Jokersherlock/Frodo_low_runahead/doc/tb_note.md

# 2025.9.11

输出寄存器使得upc的跳转延迟槽增加为2，符合预期

stall信号会让upc停止+3的位置，如在upc=2时给出stall，upc会停在5处
