Jokersherlock/Frodo_low_runahead/article.md

# 一些问题

1.  折叠hash能不能写，怎么写？
2.  以Frodo为主还是以微指令为主?
   + FrodoKEM的A的数据规模使得Hash操作与矩阵乘法的并行在低资源开销场景成为必要的操作，但是因此带来较为复杂的控制流，因此我们提出……
   + 后量子密码的专业指令往往功能复杂，每一条指令需要单独辅以较为复杂的状态机，为此我们提出了基于微指令的控制方案，并选择了Frodo加以实践
3.  设计的每一条指令需不需要都写出来格式、功能是什么样的？微指令需不需要把每一位都写出来？
4. 体现控制开销小可以使用控制模块占总体开销的百分比（其他文章的能找到么？），但如何量化额外的rom带来的存储开销（现在的往大了预估不超过448B）

# Contribution

1. 提出了一种基于微指令的控制架构
2. 设计了一个适应低资源开销场景下的FrodoKEM的硬件实现方案
3. 折叠hash?
4. 低资源开销场景下,FrodoKEM的存储策略和计算数据流(和第二点应该是1个?)
