Jokersherlock/Frodo_low_runahead/doc/Frodo矩阵乘法结构优势附加说明文档.docx

# 本专利所使用的矩阵乘法单元结构与直接相连、TPU矩阵乘法结构对比

一、直接相连矩阵乘法结构

图1 直接相连矩阵乘法结构示意图

1、 计算方法：该结构一周期能够完成（4×4）×（4×1）的矩阵乘法，见式（1.1），通过扩展，可以在多周期内完成（4×4n）×（4n×1）的矩阵乘法，见式（1.2）。图1中展示的是直接相连矩阵乘法结构进行矩阵乘法运算示意图。在进行（4×4）×（4×1）的矩阵乘法时，每个周期读入4行（即16个）A矩阵系数，并将其对应输入到矩阵乘法运算单元（MUL）中；同时读入1列（即4个）s矩阵系数，并将其对应输入到MUL的每一列中。MUL模块中输入的A矩阵和s矩阵系数对应相乘，并将相乘后的每行元素进行相加，获得该周期运算结果。在扩展为（4×4n）×（4n×1）的矩阵乘法时，每个周期运算结果与上一周期结果进行累加，并在结果寄存器中缓存，直至完成输出矩阵元素所需的全部乘加操作。

[A_00 A_10 , A_01 A_11 , A_02 A_12 , A_03 A_13 A_20 A_30 , A_21 A_31 , A_22 A_32 , A_23 A_33 ]×[s_00 s_10 s_20 s_30 ]=[B_00 B_10 B_20 B_30 ] … (1.1)

[A_00 A_10 , A_01 A_11 , A_02 A_12 , A_03 A_13 A_20 A_30 , A_21 A_31 , A_22 A_32 , A_23 A_33 A_04 A_14 , A_05 A_15 , A_06 A_16 , A_07 A_17 A_24 A_34 , A_25 A_35 , A_26 A_36 , A_27 A_37 ]×[s_00 s_10 s_20 s_30 s_40 s_50 s_60 s_70 ]=[B_00 B_10 B_20 B_30 ] … (1.2)

周期 | CC0 | CC1 | ….
矩阵A输入 | A_00 , A_01 , A_02 , A_03 A_10 , A_11 , A_12 , A_13 A_20 , A_21 , A_22 , A_23 A_30 , A_31 , A_32 , A_33 | A_04 , A_05 , A_06 , A_07 A_14 , A_15 , A_16 , A_17 A_24 , A_25 , A_26 , A_27 A_34 , A_35 , A_36 , A_37 | ….
矩阵s输入 | s_00 , s_10 , s_20 , s_30 | s_40 , s_50 , s_60 , s_70 | ….

CC0：输入 A 矩阵和 s 矩阵的前四行系数。执行 s_00 与矩阵 A 第一列各元素的乘法操作， s_10 与矩阵 A 第二列各元素的乘法操作， s_20 与矩阵 A 第三列各元素的乘法操作， s_30 与矩阵 A 第四列各元素的乘法操作。将已计算获得的 s 矩阵系数与 A 矩阵的第一行前四列系数对应相乘的结果相加，即执行 A_00 s_00 +A_01 s_10 +A_02 s_20 +A_03 s_30 操作，获得 B_00 中间过程值，并将其缓存在计算单元中。 B_10 ， B_20 ， B_30 中间过程值的计算与缓存过程以此类推。

CC1：输入 A 矩阵和 s 矩阵的后四行系数。执行 s 00与矩阵 A 第五列各元素的乘法操作， s 10与矩阵 A 第六列各元素的乘法操作， s 20与矩阵 A 第七列各元素的乘法操作， s 30与矩阵 A 第八列各元素的乘法操作。将已计算获得的 s 矩阵系数与 A 矩阵的第一行系数后四列对应相乘的结果相加，即执行 A_04 s_40 +A_05 s_50 +A_06 s_60 +A_07 s_70 操作，再与缓存的中间过程值累加，获得 B_00 最终计算结果。 B_10 ， B_20 ， B_30 的计算过程以此类推。

CC2~CCn：依次类推，直至完成全部矩阵乘法运算。

2、所需最大带宽： （4 data+16 data）×16bit/data=320 bit。

3、计算 (m×n)×(n×k) 矩阵所需周期： m/4×n/4×k=(m×n×k)/16 。以（640×640）×（640×8）为例，所需周期为204800。

4、所需乘法器、加法器与寄存器个数： 16个乘法器，16个加法器，20个16-bit寄存器（4个16-bit寄存器用于存储计算结果， 16个16-bit寄存器用于储存当前乘法结果）。

2、 TPU矩阵乘法结构

图2 TPU矩阵相乘结构

1、计算方法：该结构可以在多周期内完成（4×4n）×（4n×4）的矩阵乘法，以（4×8）×（8×4）为例，见式（1.3）。以矩阵A与矩阵s相乘的过程（矩阵维度均为4×4）为例，见式（1.2）。将A矩阵与s矩阵系数以一种类似平行四边形的顺序输入到矩阵运算单元的硬件电路中，并在硬件电路内部进行数据流动，实现数据的时分复用。计算细节如下所示：

[A_00 A_10 , A_01 A_11 , A_02 A_12 , A_03 , A_04 , A_05 , A_06 , A_07 A_13 , A_14 , A_15 , A_16 , A_17 A_20 A_30 , A_21 A_31 , A_22 A_32 , A_23 , A_24 , A_25 , A_26 , A_27 A_33 , A_34 , A_35 , A_36 , A_37 ]×[s_00 s_10 , s_01 s_11 , s_02 s_12 , s_03 s_13 s_20 s_30 s_40 s_50 s_60 s_70 , s_21 s_31 s_41 s_51 s_61 s_71 , s_22 s_32 s_42 s_52 s_62 s_72 , s_23 s_33 s_43 s_53 s_63 s_73 ]=[B_00 B_10 , B_01 B_11 , B_02 B_12 , B_03 B_13 B_20 B_30 , B_21 B_31 , B_22 B_32 , B_23 B_33 ]

… (1.3)

计算细节：

周期 | CC0 | CC1 | CC2 | CC3 | CC4 | ….
矩阵A 输入 | A30 | A31, A20 | A32, A21, A10 | A33, A22, A11, A00 | A34, A23, A12, A01 | ….
矩阵s 输入 | s00 | s10, s01 | s20, s11, s02 | s30, s21, s12, s03 | s40, s31, s22, s13 | ….

CC0：在乘法单元第1列，第四行位的MAC单元中执行A30×s00的乘法操作，并将结果缓存在计算单元中。

CC1：在矩阵第1列，第3~4行的MAC单元中，分别执行A20×s00，A31×s10的操作，并将结果与缓存结果相加；在矩阵第2列，第4行的MAC单元中，执行A30×s01的操作，并将结果缓存在计算单元中。

CC2：在矩阵第1列，第2~4行的MAC单元中，分别执行A10×s00，A21×s10，A32×s20的操作，并将结果与缓存结果相加；同时在矩阵第2列，第3~4行的MAC单元中，分别执行A20×s01，A31×s11的操作，并将结果与缓存结果相加；同时在矩阵第3列，第4行的MAC单元中，执行A30×s02的操作，并将结果缓存在计算单元中。

CC3：在矩阵第1列，第1~4行的MAC单元中，分别执行A30×s00，A30×s00，A30×s00，A30×s00的操作，并将结果与缓存结果相加，此时，完成B30元素的全部计算；在矩阵第2列，第2~4行的MAC单元中，分别执行A10×s01，A21×s11，A32×s21的操作，并将结果与缓存结果相加；同时在矩阵第3列，第3~4行的MAC单元中，分别执行A20×s02，A31×s12的操作，并将结果与缓存结果相加；同时在矩阵第4列，第4行的MAC单元中，执行A30×s03的操作，并将结果缓存在计算单元中。

CC4：在矩阵第1列，第1~4行的MAC单元中，分别执行A30×s00，A30×s00，A30×s00，A30×s00的操作，并将结果与缓存结果相加，此时，完成B30元素的全部计算；在矩阵第2列，第1~4行的MAC单元中，分别执行A10×s01，A21×s11，A32×s21的操作，并将结果与缓存结果相加；同时在矩阵第3列，第2~4行的MAC单元中，分别执行A20×s02，A31×s12的操作，并将结果与缓存结果相加；同时在矩阵第4列，第4行的MAC单元中，第3~4行的MAC单元中，分别执行A20×s02，A31×s12的操作，并将结果与缓存结果相加。

CC5~CCn：依次类推，直至完成全部矩阵乘法运算。

2、为保证乘法阵列电路流水运行所需带宽： （4 data+4 data）×16 bit/data=128 bit 。

3、计算 (m×n)×(n×k) 矩阵所需周期： 10+4×（m/4×n/4×k/4−1） 。以（640×640）×（640×8）为例，所需周期为204806。

4、所需乘法器、加法器与寄存器个数：16个乘法器，16个加法器，40个16-bit寄存器（16个16-bit寄存器用于存储累加结果，12个16-bit寄存器用于存储A矩阵元素，12个16-bit寄存器用于存储s矩阵元素）。

三、本专利所使用的矩阵相乘结构

图4 一种适用于Frodo算法的矩阵乘法结构

1、 计算方法：该结构可以在多周期内完成（4×4n）×（4n×4）的矩阵乘法，以（4×8）×（8×4）为例，见式（1.4）。矩阵A内部各元素按反斜向对角顺序依次输入硬件计算电路，每个元素同时连接到4个计算单元的输入端口，实现空间上的数据复用。矩阵s内部各元素按行输入硬件计算电路，并在硬件电路内部进行流动，实现时间上的数据复用。每周期乘法运算结果在乘法单元内部缓存，并与下一周期计算结果进行累加，直至完成输出矩阵元素所需的全部乘加操作。

[A_00 A_10 , A_01 A_11 , A_02 A_12 , A_03 , A_04 , A_05 , A_06 , A_07 A_13 , A_14 , A_15 , A_16 , A_17 A_20 A_30 , A_21 A_31 , A_22 A_32 , A_23 , A_24 , A_25 , A_26 , A_27 A_33 , A_34 , A_35 , A_36 , A_37 ]×[s_00 s_10 , s_01 s_11 , s_02 s_12 , s_03 s_13 s_20 s_30 s_40 s_50 s_60 s_70 , s_21 s_31 s_41 s_51 s_61 s_71 , s_22 s_32 s_42 s_52 s_62 s_72 , s_23 s_33 s_43 s_53 s_63 s_73 ]=[B_00 B_10 , B_01 B_11 , B_02 B_12 , B_03 B_13 B_20 B_30 , B_21 B_31 , B_22 B_32 , B_23 B_33 ]

… (1.4)

周期 | CC0 | CC1 | CC2 | CC3 | CC4 | ….
矩阵A输入 | A00 | A01，A10 | A02，A11，A20 | A03，A12，A21，A30 | A04，A13，A22，A31 | ….
矩阵s 输入 | s00, s01, s02, s03 | s10, s11, s12, s13 | s20, s21, s22, s23 | s30, s31, s32, s33 | s40, s41, s42, s43 | ….

CC0：执行A00与矩阵s第一行各元素的乘法操作，并将结果缓存在计算单元中。

CC1：执行A01与矩阵s第二行各元素的乘法操作，并将结果与缓存结果相加；同时执行A10与矩阵s第一行各元素的乘法操作，并将结果缓存在计算单元中。

CC2：执行A02与矩阵s第三行各元素的乘法操作，并将结果与缓存结果相加；同时执行A11与矩阵s第二行各元素的乘法操作，并将结果与缓存结果相加；同时执行A20与矩阵s第一行各元素的乘法操作，并将结果缓存在计算单元中。

CC3：执行A03与矩阵s第四行各元素的乘法操作，并将结果与缓存结果相加；同时执行A12与矩阵s第三行各元素的乘法操作，并将结果与缓存结果相加；同时执行A21与矩阵s第二行各元素的乘法操作，并将结果与缓存结果相加。同时执行A30与矩阵s第一行各元素的乘法操作，并将结果缓存在计算单元中。

CC4：执行A04与矩阵s第五行各元素的乘法操作，并将结果与缓存结果相加；同时执行A13与矩阵s第四行各元素的乘法操作，并将结果与缓存结果相加；同时执行A22与矩阵s第三行各元素的乘法操作，并将结果与缓存结果相加。同时执行A31与矩阵s第二行各元素的乘法操作，并将结果缓存在计算单元中。

CC5~CCn：依次类推，直至完成全部矩阵乘法运算。

2、所需最大带宽： （4 data+4 data）×16 bit/data=128 bit。

3、计算 (m×n)×(n×k) 矩阵所需周期： 4×m/4×n/4×k/4+3 。以（640×640）×（640×8）为例，所需周期为204803。

4、所需乘法器、加法器与寄存器个数：16个乘法器，16个加法器，28个16-bit寄存器（16个16-bit寄存器用于存储累加结果， 12个16-bit寄存器用于存储s矩阵元素）。

以硬件乘法单元进行（640×640）×（640×8）计算为例：

| 所需带宽（bit） | 所需周期数 | 资源开销 | | | 乘法阵列维度
| | | 乘法器 | 加法器 | 寄存器
直接相连结构 | 320 | 204800 | 16 | 16 | 20 | （4×4）×（4×1）
TPU结构 | 128 | 204806 | 16 | 16 | 40 | （4×4）×（4×4）
本专利 结构 | 128 | 204803 | 16 | 16 | 28 | （4×4）×（4×4）

与直接相连结构相比，在所需周期数几乎相同的情况下，本专利结构所需的带宽仅为直接相连结构的2/5，这一优化显著减轻了数据传输过程中对于带宽的压力,同时直接相连结构只能单次计算（4×4n）×（4n×1）矩阵相乘，而本设计结构能单次计算（4×4n）×（4n×4）矩阵相乘。与TPU结构相比，在所需带宽相同，所需周期数几乎相同的情况下，所需寄存器的个数明显少于TPU结构，有着更出色的资源利用效率。

综上所述，本专利结构在显著降低带宽需求的同时，减少了寄存器资源消耗，为提高Frodo算法中矩阵乘法硬件执行速度提供一种高性能、高资源利用率的硬件实现方案。
