Jokersherlock/Frodo_low_runahead/doc/Frodo硬件实现评估报告-低资源开销-第二部分.docx

全安全等级Frodo硬件实现评估报告

低资源开销设计（第二部分）

版本：Ver. 1.4

审核人：陆家昊

批准人：刘冬生

编写人：赵正鹏、王家琛

##### 版本记录

序号 | 版本号 | 生成时间 | 主 要 修 改 记 录 | 作者
| V1.0 | 20250713 | 创建文档 | 赵正鹏、王家琛
| V1.1 | 20250720 | 完成第一版报告 | 赵正鹏、王家琛
| V1.2 | 20250725 | 增添PTPX分析与实际上板波形 | 赵正鹏、王家琛

# 目录

# 1. 仿真结果

## 1.1. 仿真结果验证

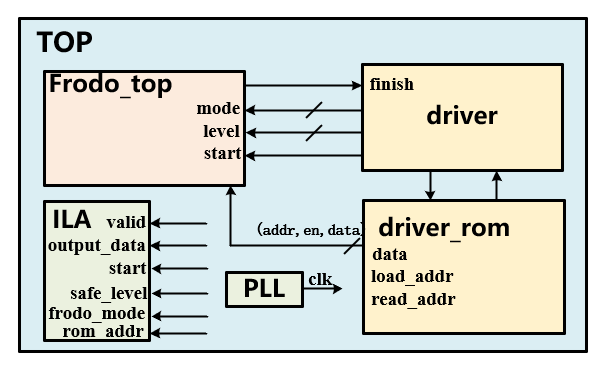
[picture p2: figure]

上图为测试仿真方案，Frodo本体（Frodo_top）与驱动（driver）被封装在一个TOP中，diver控制driver_rom对Frodo内RAM进行数据的初始化，完成初始化后向本体发送安全等级（level）、具体算法（mode）、工作启动信号（start），开始执行Frodo算法，在一个算法流程执行完毕后，diver控制driver_rom从RAM中读出运算结果数据。

输出数据的地址规划（用于结果的正确性验证）：

pkh(Keygen) | RAM1 | 0xFD2~0xFD5
ss(Encap) | RAM0 | 0xFFC~0xFFF
ss(Decap) | RAM1 | 0xFD6~0xFD9

仿真测试初始数据：

FrodoKEM 640 SHAKE | s_seedSE_z randomness: 7c9935a0b07694aa0c6d10e4db6b1add2fd81a25ccb148032dcd739936737f2db505d7cfad1b497499323c8686325e4792f267aafa3f87ca60d01cb54f29202a mu_salt randomness: eb4a7c66ef4eba2ddb38c88d8bc706b1d639002198172a7b1942eca8f6c001ba26202bee59ac275484ea767d41d8d357
FrodoKEM 976 SHAKE | s_seedSE_z randomness: 7c9935a0b07694aa0c6d10e4db6b1add2fd81a25ccb148032dcd739936737f2db505d7cfad1b497499323c8686325e4792f267aafa3f87ca60d01cb54f29202a3e784ccb7ebcdcfd45542b7f6af778742e0f4479175084aa mu_salt randomness: ee716762c15e3b72aa7650a63b9a510040b03c0fe70475c0463bbc45a0ba5b7980dd46eef82fb062035077d042f306bb6391040e0dd965f1fda9d183ca9fccb48fc010b184ab0033
FrodoKEM 1344 SHAKE | s_seedSE_z randomness: 7c9935a0b07694aa0c6d10e4db6b1add2fd81a25ccb148032dcd739936737f2db505d7cfad1b497499323c8686325e4792f267aafa3f87ca60d01cb54f29202a3e784ccb7ebcdcfd45542b7f6af778742e0f4479175084aa488b3b74340678aa38e22e9628b0a161fdeb0bd252173b9c mu_salt randomness: 9f08587687ff66765c671de73e918d2823ca573ff4e7a31a9160324026e540eacb3a04e0d54c75deb9705bfdfbdf935a7528802ee6e5b0c6a73b2b761d9bd0848a6e4cf3fc4ca84f14e0331af35bfef41e42b13a6dae6df937f738c1857ba1ca

### 1.1.1. Frodo640

硬件仿真结果

Keygen生成pkh

mem1_addr = fd2 , output_data = db2e85b3977dca13

mem1_addr = fd3 , output_data = adfb88507c1be248

软件结果(左为低位)：

//pkh

13ca7d97b3852edb

48e21b7c5088fbad

Encaps生成ss

mem0_addr = ffc , output_data = 11fbdbd5e72cd42e

mem0_addr = ffd , output_data = fab350b6dc2b2e5f

软件结果(左为低位)：

//ss(Encaps)

2ed42ce7d5dbfb11

5f2e2bdcb650b3fa

Decaps生成ss

mem1_addr = fd6 , output_data = 11fbdbd5e72cd42e

mem1_addr = fd7 , output_data = fab350b6dc2b2e5f

软件结果(左为低位)：

//ss(Decaps)

2ed42ce7d5dbfb11

5f2e2bdcb650b3fa

通过比对，数据一致，说明Frodo640安全等级下，各算法流程执行正确

### 1.1.2. Frodo976

硬件仿真结果

Keygen生成pkh

mem1_addr = fd2 , output_data = 3e04668a8d7a1f9b

mem1_addr = fd3 , output_data = af5072a3962884da
mem1_addr = fd4 , output_data = cfc763dd12a3802c

软件结果(左为低位)：

//pkh

9b1f7a8d8a66043e

da842896a37250af

2c80a312dd63c7cf

Encaps生成ss

mem0_addr = ffc , output_data = e7f8d5a3695a6e5b

mem0_addr = ffd , output_data = d05e59956e3aea5e
mem0_addr = ffd , output_data = 4231378b5ba58d27

软件结果(左为低位)：

//ss(Encaps)

5b6e5a69a3d5f8e7

5eea3a6e95595ed0

278da55b8b373142

Decaps生成ss

mem1_addr = fd6 , output_data = e7f8d5a3695a6e5b

mem1_addr = fd7 , output_data = d05e59956e3aea5e
mem1_addr = fd8 , output_data = 4231378b5ba58d27

软件结果(左为低位)：

//ss(Dncaps)

5b6e5a69a3d5f8e7

5eea3a6e95595ed0

278da55b8b373142

通过比对，数据一致，说明Frodo976安全等级下，各算法流程执行正确

### 1.1.3. Frodo1344

硬件仿真结果

Keygen生成pkh

mem1_addr = fd2 , output_data = 1620695d8773363a

mem1_addr = fd3 , output_data = 96ba22f90b7b5e27
mem1_addr = fd4 , output_data = df0445d51223a7b1

mem1_addr = fd5 , output_data = 797d67e53576d438

软件结果(左为低位)：

//pkh

3a3673875d692016

275e7b0bf922ba96

b1a72312d54504df

38d47635e5677d79

Encaps生成ss

mem0_addr = ffc , output_data = 9ef14d4671f9208d

mem0_addr = ffd , output_data = e2d0af85d3bd6105

mem0_addr = ffd , output_data = 635ad4ef12e20cef

mem0_addr = ffe , output_data = ac6ad6f3642c5d2f

软件结果(左为低位)：

//ss(Encaps)

8d20f971464df19e

0561bdd385afd0e2

ef0ce212efd45a63

2f5d2c64f3d66aac

Decaps生成ss

mem1_addr = fd6 , output_data = 9ef14d4671f9208d

mem1_addr = fd7 , output_data = e2d0af85d3bd6105
mem1_addr = fd8 , output_data = 635ad4ef12e20cef

mem1_addr = fd9 , output_data = ac6ad6f3642c5d2f

软件结果(左为低位)：

//ss(Decaps)

8d20f971464df19e

0561bdd385afd0e2

ef0ce212efd45a63

2f5d2c64f3d66aac

通过比对，数据一致，说明Frodo1344安全等级下，各算法流程执行正确

### 1.1.4. 运算时间评估

工程在switch信号上升沿来临开始进行某一算法流程测试，在初始化必要的输入数据后驱动会拉高start从而Frodo本体进行工作，运算结束后valid信号会拉高。一个算法流程的所耗时间从start信号的上升沿开始至valid信号上升沿结束。

以Frodo640为例，可见一个等级下的算法流程运行顺序

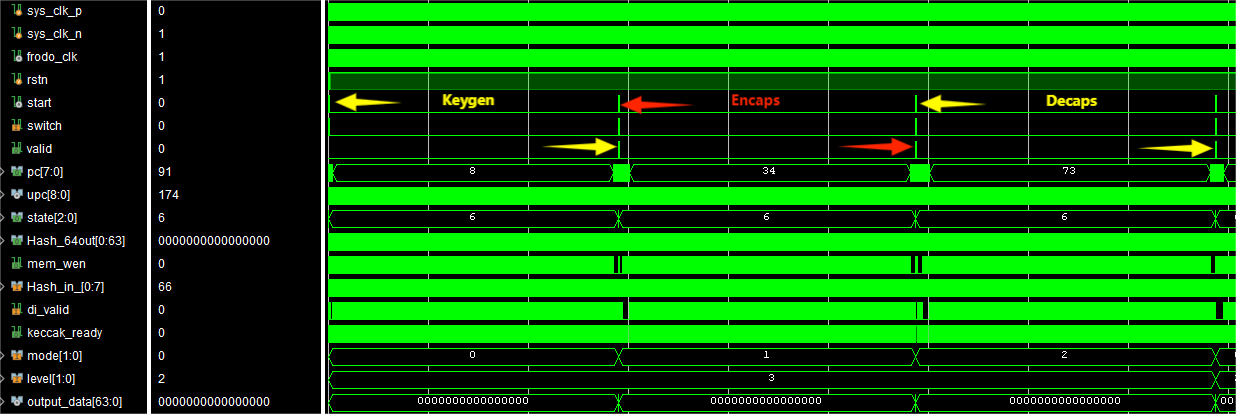
[picture p3: figure]

为方便计算，设置驱动时钟(Frodo_clk)为100Mhz

Frodo640-keygen：

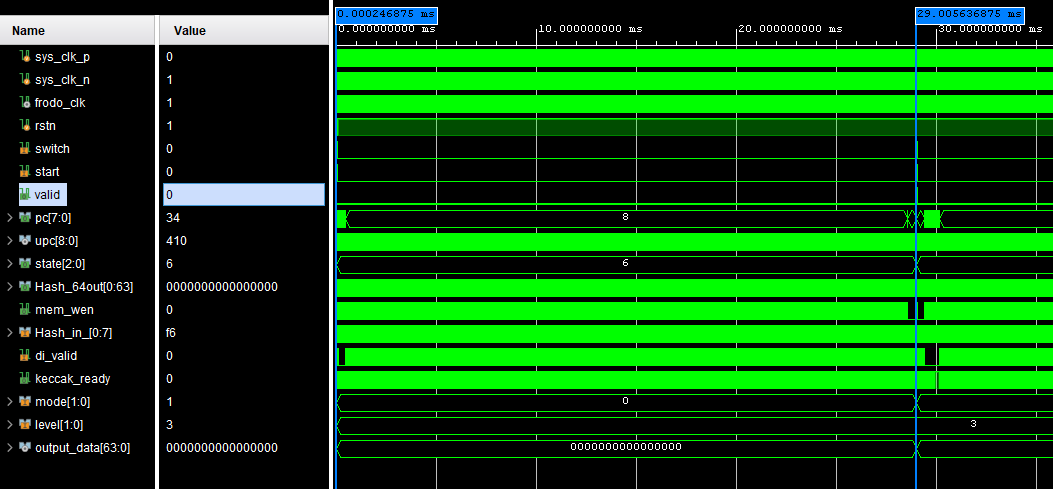
[picture p4: figure]

耗时29,005,390ns，共计2,900,539个周期

Frodo640-Encaps：

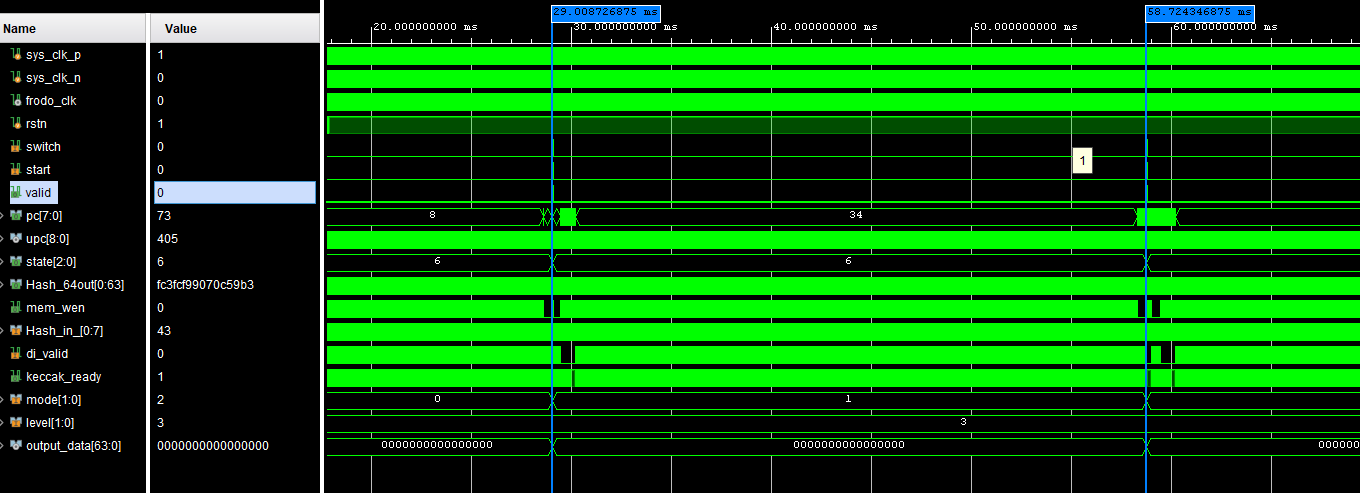
[picture p5: figure]

耗时29,715,620ns，共计2,971,562个周期

Frodo640-Decaps：

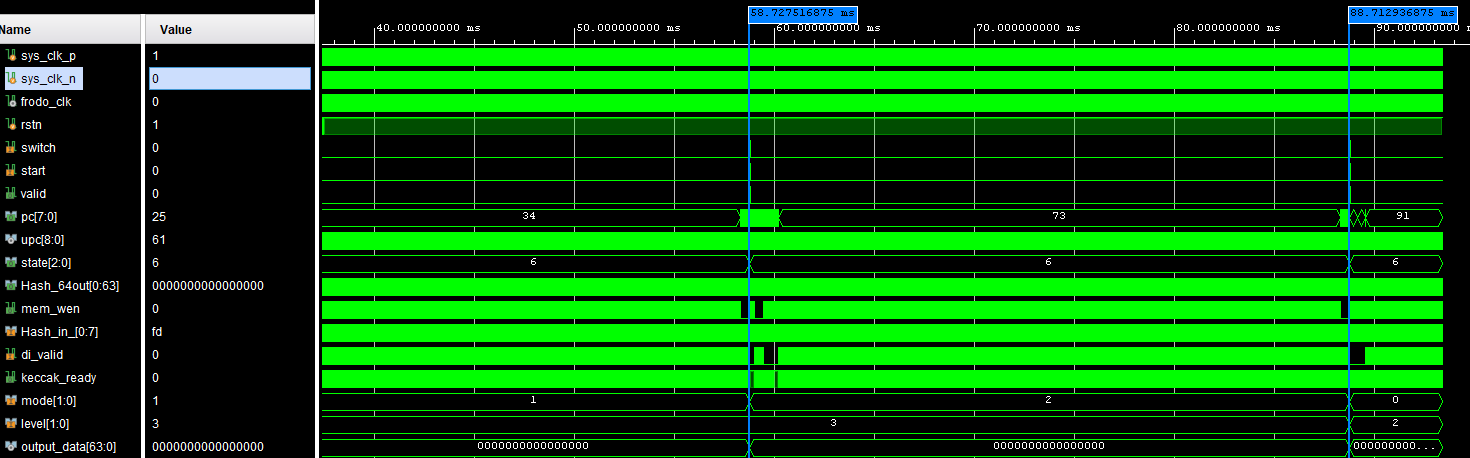
[picture p6: figure]

耗时29,985,420ns，共计2,998,542个周期

Frodo976-keygen：

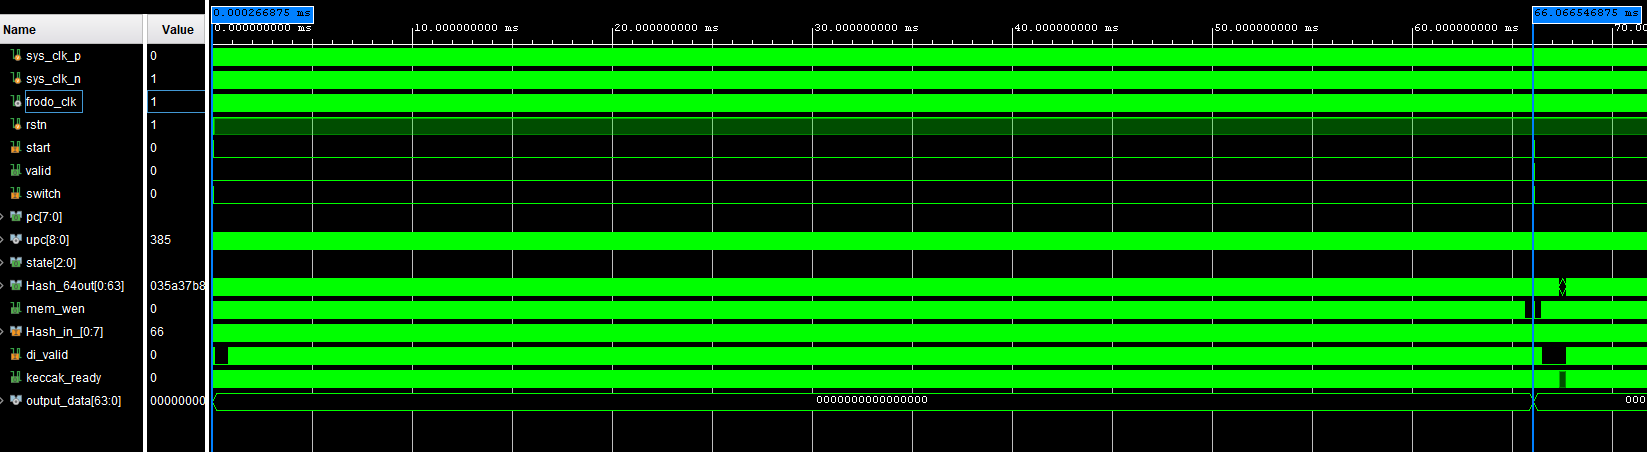
[picture p7: figure]

耗时66,063,280ns，共计6,606,328个周期

Frodo976-Encaps：

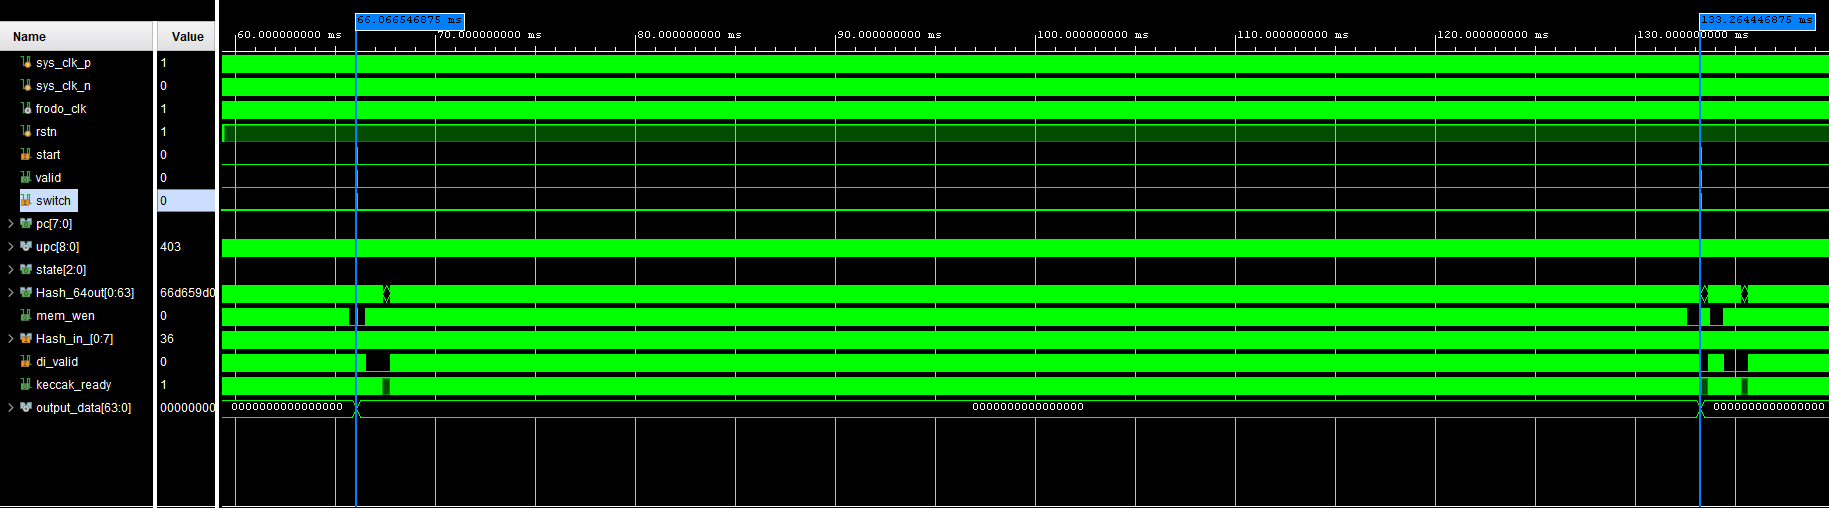
[picture p8: figure]

耗时67,194,600ns，共计6,719,460个周期

Frodo976-Decaps

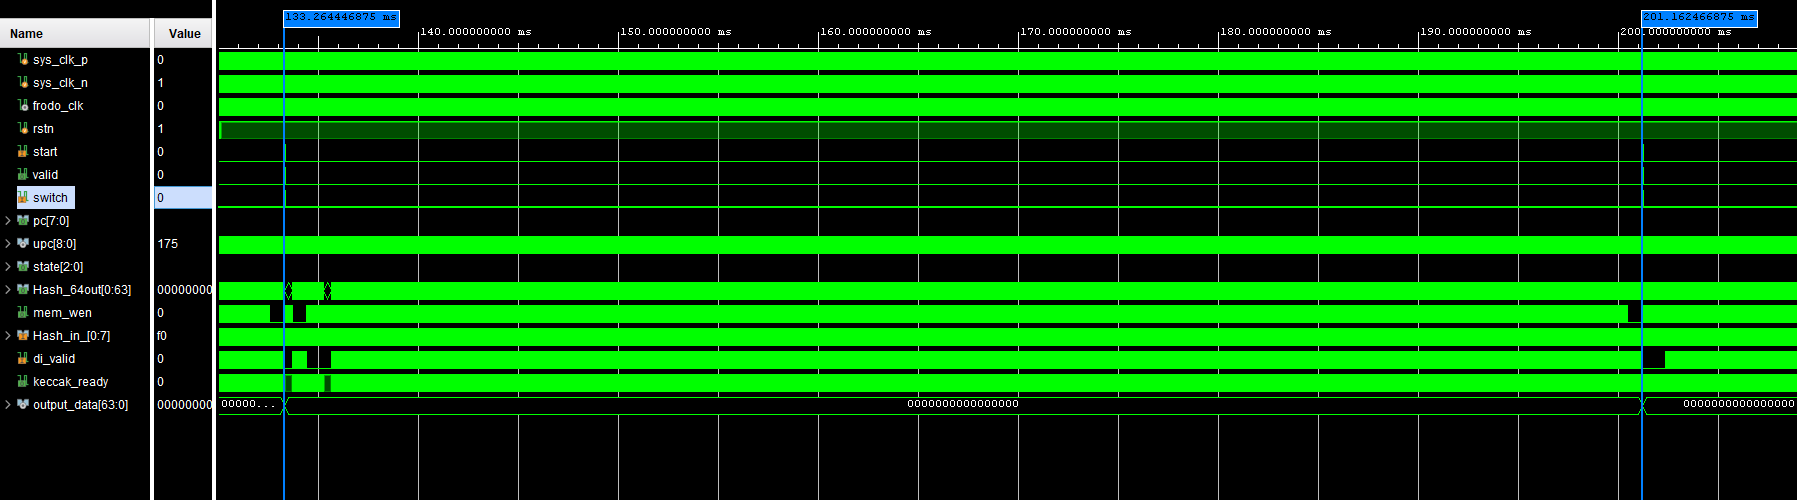
[picture p9: figure]

耗时67,898,030ns，共计6,789,803个周期

Frodo1344-keygen

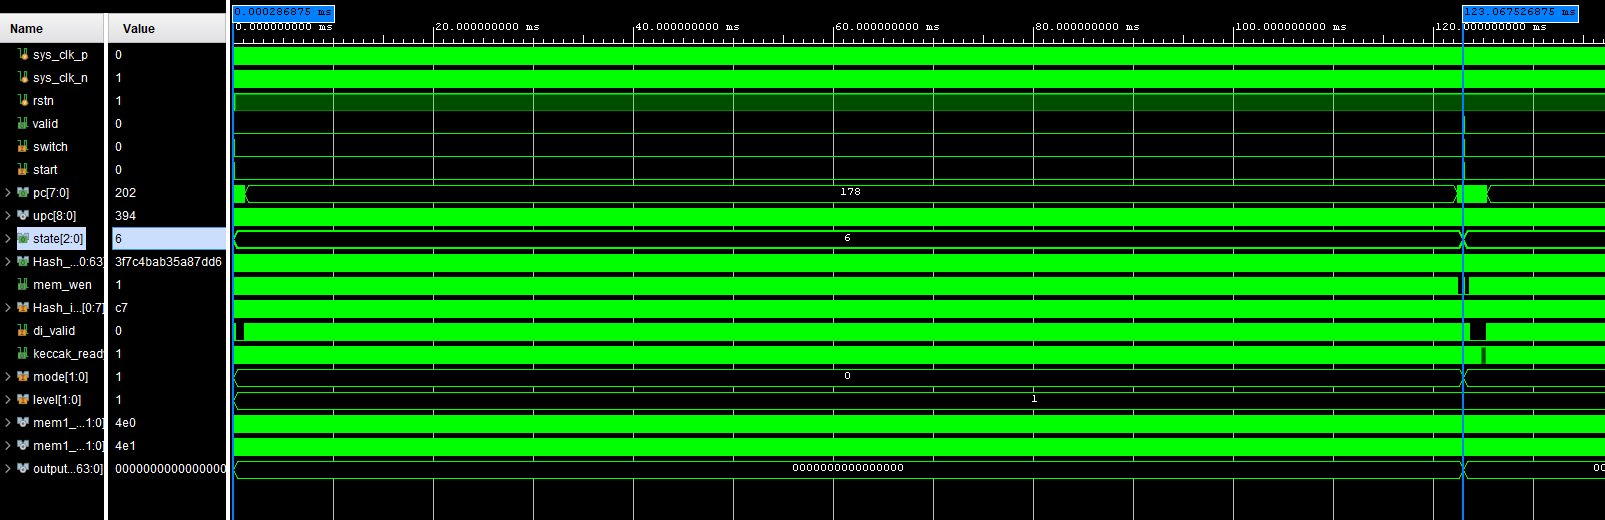
[picture p10: figure]

耗时123,067,240ns，共计12,306,724个周期

Frodo1344-Encaps

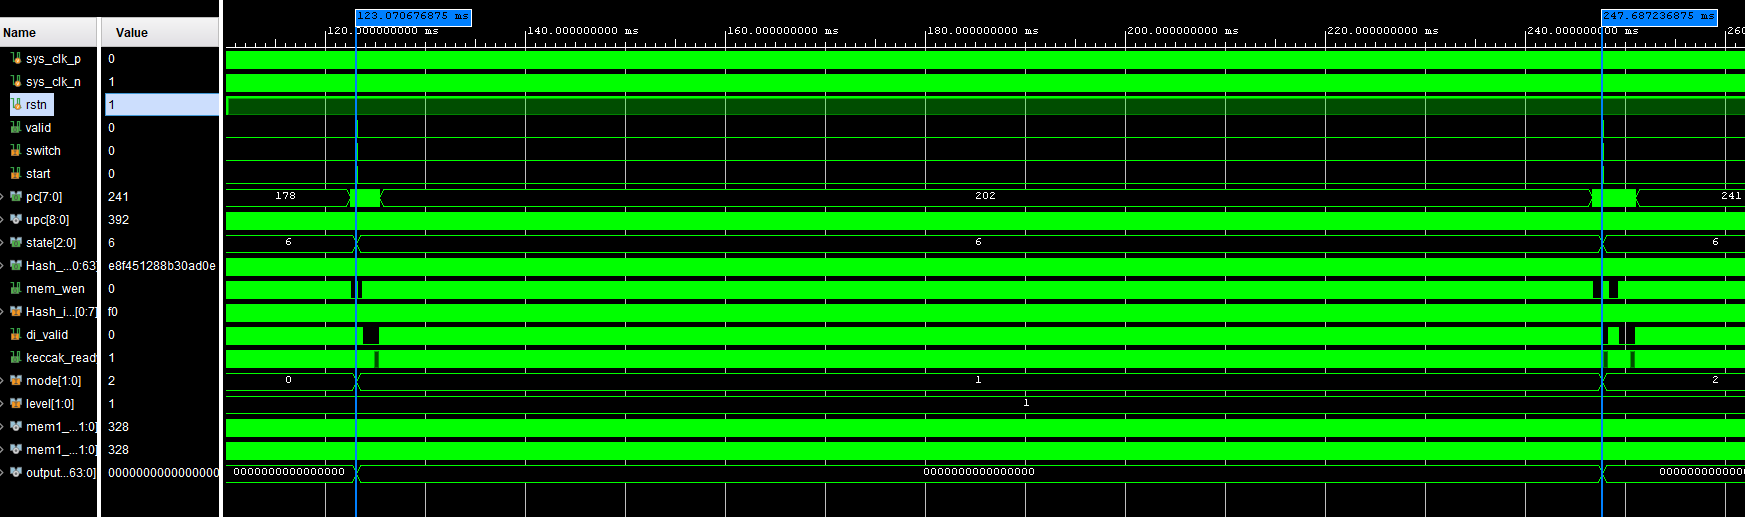
[picture p11: figure]

耗时124,616,560ns，共计12,461,656个周期

Frodo1344-Decaps

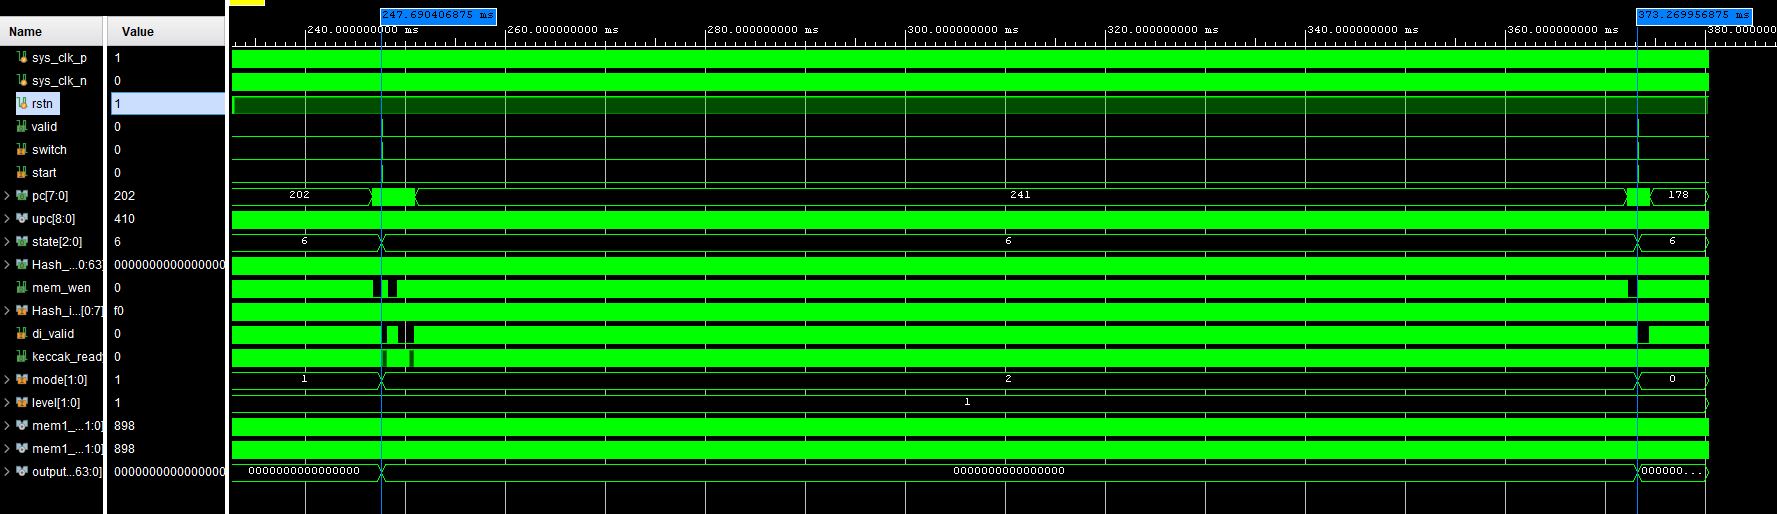
[picture p12: figure]

耗时125,579,550ns，共计12,557,955个周期

运行周期数 | Keygen | Encaps | Decaps
Frodo640 | 2,900,539 | 2,971,562 | 2,998,542
Frodo976 | 6,606,328 | 6,719,460 | 6,789,803
Frodo1344 | 12,306,724 | 12,461,656 | 12,557,955

运行时间(100MHz时钟下) | Keygen | Encaps | Decaps
Frodo640 | 29.01ms | 29.71ms | 29.99ms
Frodo976 | 66.06ms | 67.19ms | 67.90ms
Frodo1344 | 123.07ms | 124.61ms | 125.58ms

## 1.2. 子模块仿真波形

### 1.2.1. RAM读写

整体波形：

RAM的直接相连端口为mem_xx_xx信号，通过驱动传入的RAM端口信号为load_addr、load_data、load_en、read_addr、read_data，Frodo本体控制的RAM端口信号为Frodo_xx。在不同阶段mem_xx信号会与驱动传入信号或Frodo本体控制的RAM端口相连。

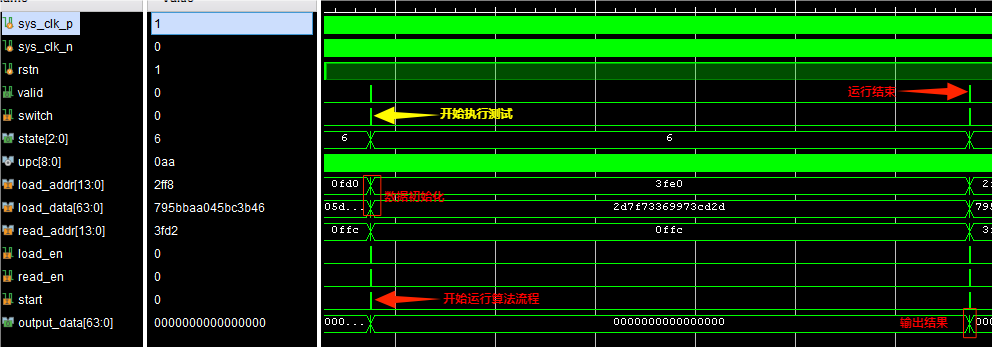
[picture p13: figure]

运行算法流程前的初始化数据：

此时RAM的地址与写数据端口分别受load_addr与load_data驱动，其中load_addr高两位为RAM索引区分此时控制RAM1还是RAM0.

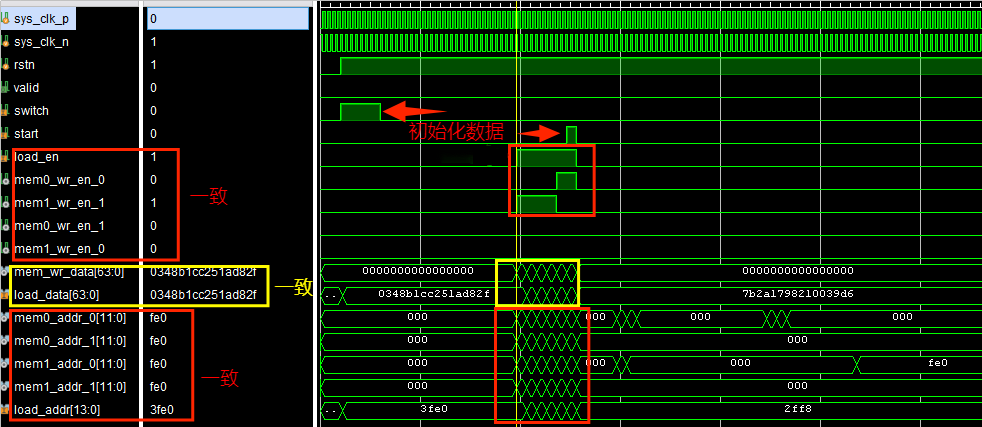
[picture p14: figure]

运行算法流程：

此时RAM的地址与写数据端口分别受frodo_memx_addr_x与frodo_mem_wr_data驱动。

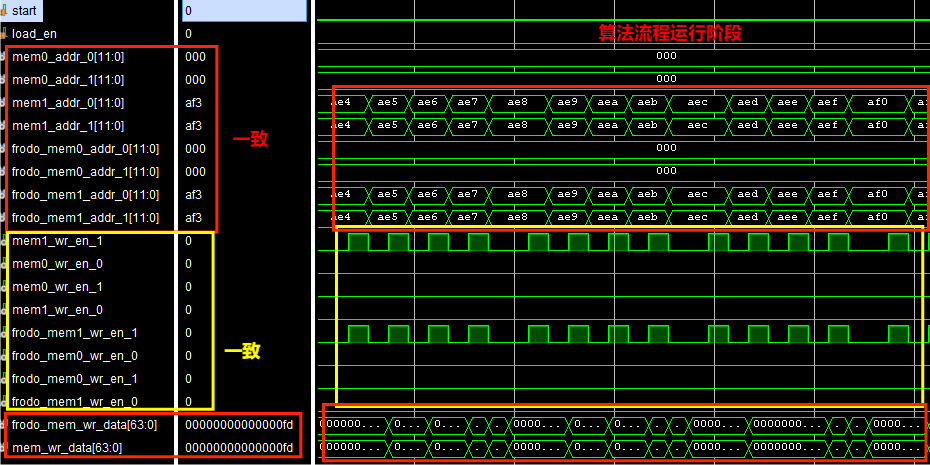
[picture p15: figure]

结束算法流程后读出结果数据：

此时RAM的地址受read_addr驱动,读数据会连至output_data。

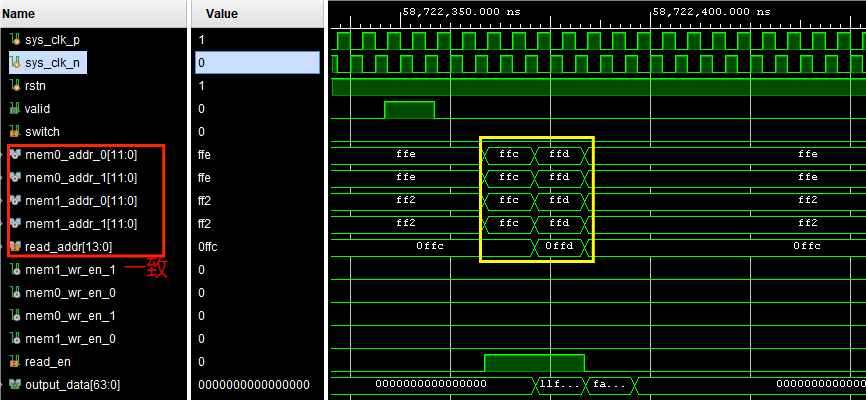
[picture p16: figure]

### 1.2.2. 指令执行

指令控制体系采取二级指令调度，一个指令指示一个工作(如:矩阵运算，输出S)的运行，指令给出所需参数。通过待机-取指-译码-执行的流程控制子模块，在执行阶段，通过一条条微指令进行具体子模块信号的控制。

单指令下波形：

多个指令整体波形：

一个指令对应一个待机-取指-译码-执行的流程循环。

### 1.2.3. 哈希模块

下图为Hash模块工作仿真波形：

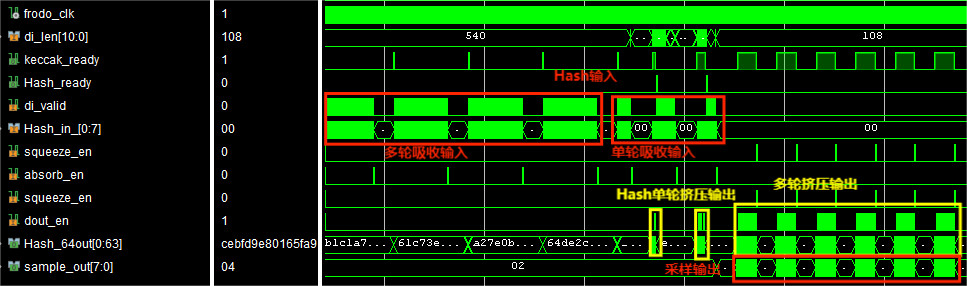
[picture p17: figure]

挤压输出的结果直接连到采样输出，根据具体情况决定是直接采用挤压输出值还是

采样输出值。

### 1.2.4. PE阵列

下图PE阵列工作过程仿真波形：

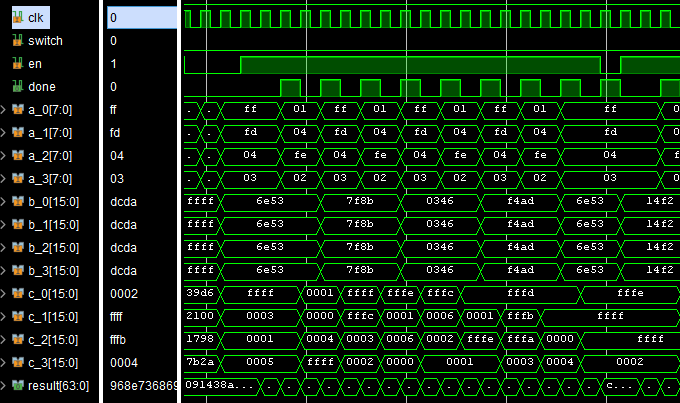
[picture p18: figure]

输入数据与使能有效后，下一个周期输出乘积，再下一周期输出乘加运算结果。输出数据位宽为64位，即将四个计算结果并行输出。

# 2. 硬件评估结果

Vivado版本:

Vivado v2024.2 (64-bit)

SW Build 5239630 on Fri Nov 08 22:35:27 MST 2024

IP Build 5239520 on Sun Nov 10 16:12:51 MST 2024

Tool Version Limit: 2024.11

Copyright 1986-2022 Xilinx, Inc. All Rights Reserved.

Copyright 2022-2024 Advanced Micro Devices, Inc. All Rights Reserved.

SharedData Build 5239561 on Fri Nov 08 14:39:27 MST 2024

FPGA型号:xcku15p-ffve1517-2-i

## 2.1. Synthesis结果

### 2.1.1. 硬件资源评估

综合后硬件资源评估结果如下，共消耗6359个LUT、4428个FF、19.5个BRAM和4个DSP。

其中Frodo本体(u_Frodo_top )共消耗5205个LUT、2730个FF、16个 BRAM和4个DSP。

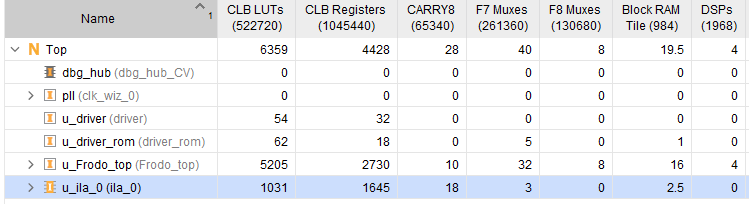
[picture p19: figure]

### 2.1.2. 最高频率估计

综合的时序评估如下，建立时间的裕度为4.841ns，评估得到的最高频193.8MHz。综合过程的Hold Slack不用考虑。

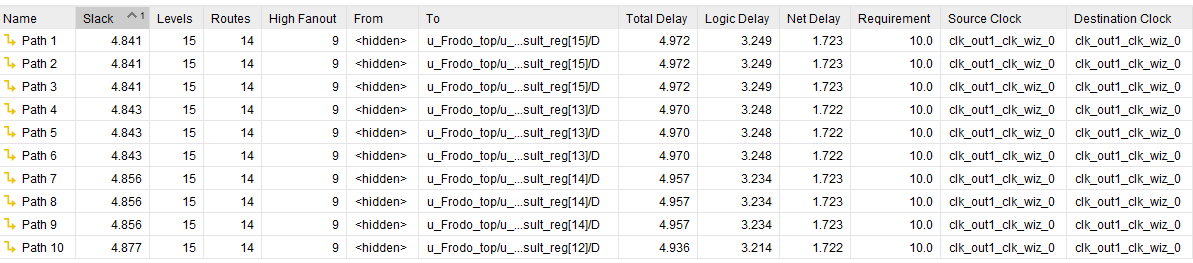
[picture p20: figure]

### 2.1.3. 功耗评估

### 功耗评估如下：

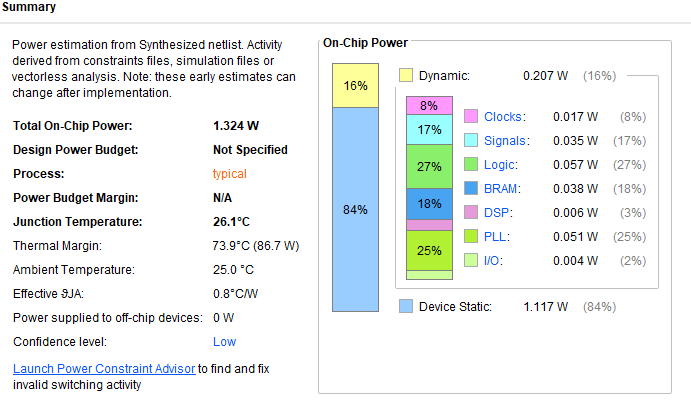
[picture p21: figure]

## 2.2. Implementation结果

### 2.2.1. 硬件资源评估

实现后硬件资源评估结果如下，共消耗6640个LUT、4923个FF、19.5个BRAM和4个DSP。

其中Frodo本体(u_Frodo_top )共消耗5144个LUT、2530个FF、16个 BRAM和4个DSP。

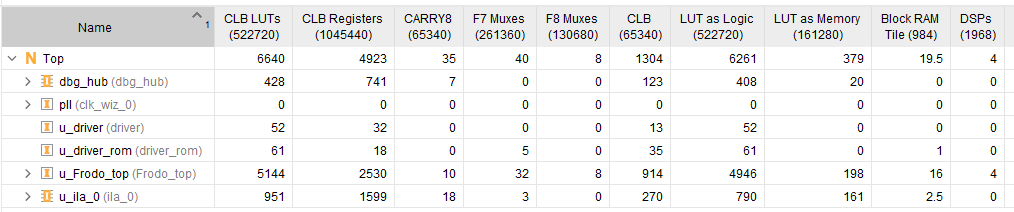
[picture p22: figure]

### 2.2.2. 最高频率估计

实现后的时序评估如下，建立时间的裕度为2.682ns，评估得到的最高频136.6MHz。

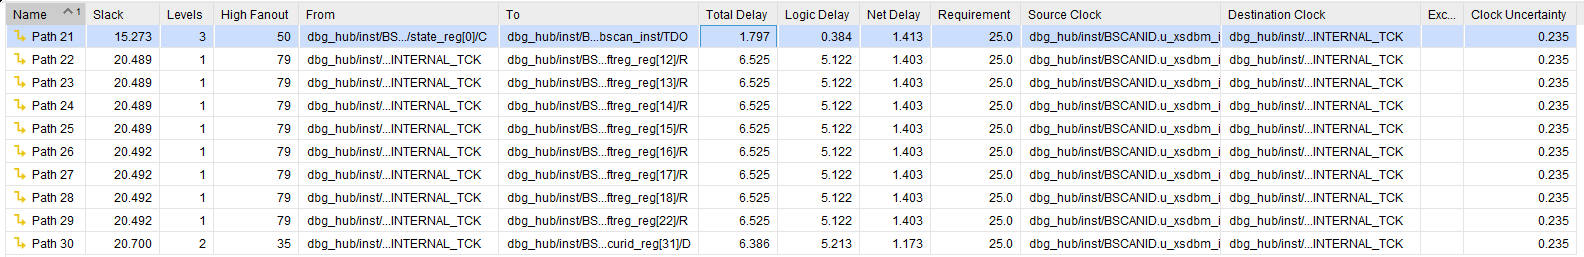
[picture p23: figure]
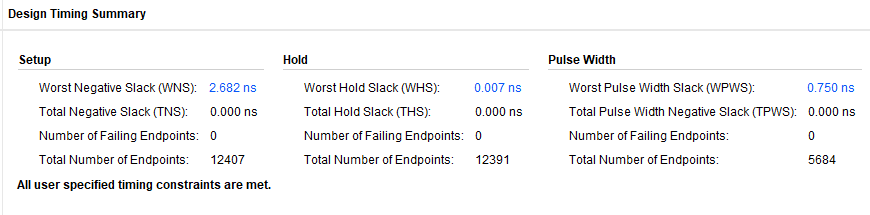
[picture p24: figure]

### 2.2.3. 功耗评估

### 功耗评估如下：

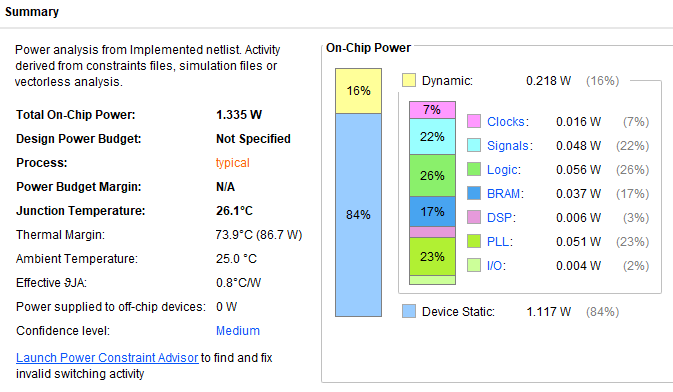
[picture p25: figure]

## 2.3. 等效逻辑门数评估

以下为DC综合所得Total cell area


可得Total cell area为166721.015792，保守估计等效逻辑门数为315,043.49，在31万等效逻辑门左右，远小于预期的100万门，且在不同驱动能力下等效逻辑门数可能有所降低，符合小于100万的门要求。

## 2.4. PTPX功耗分析

### 2.4.1. 在16Mhz时钟下功耗分析

16Mhz时钟下的PTPX功耗分析报告如下：

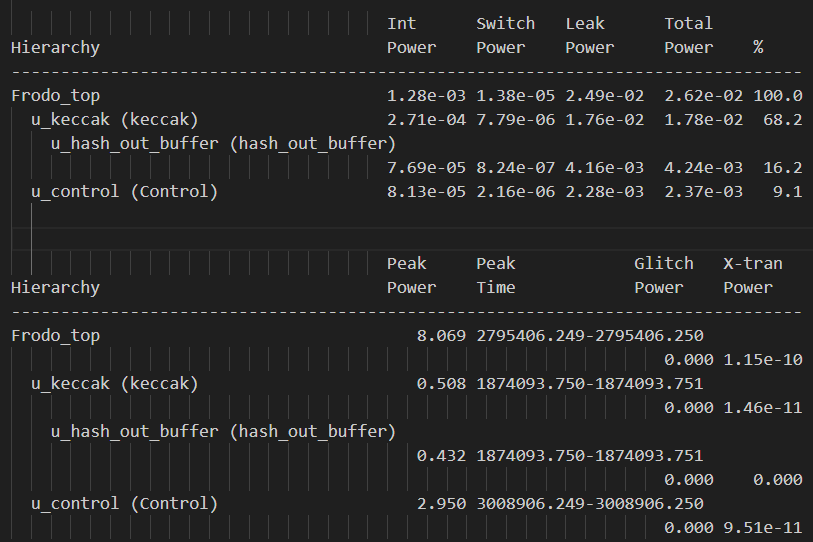
[picture p26: figure]

由图可知16Mhz下PTPX分析出的总峰值功耗为8.069w，其他数据如下表所示：

模块 | Int Power(w) | Swtich Power(w) | Leak Power(w) | Total Power(w)
总体工程 | 1.28e ⁻ ³ | 1.38e ⁻ ⁵ | 2.49e ⁻ ² | 2.62e ⁻ ²
keccak | 2.71e ⁻ ⁴ | 7.79e ⁻ ⁶ | 1.76e ⁻ ² | 1.78e ⁻ ²
Control | 8.13e ⁻ ⁵ | 2.16e ⁻ ⁶ | 2.28e ⁻ ³ | 2.37e ⁻ ³
其他模块 | 9.28e ⁻ ⁴ | 3.85e ⁻ ⁶ | 5.02e ⁻ ³ | 6.03e ⁻ ³

### 2.4.2. 在24Mhz时钟下功耗分析

16Mhz时钟下的PTPX功耗分析报告如下：

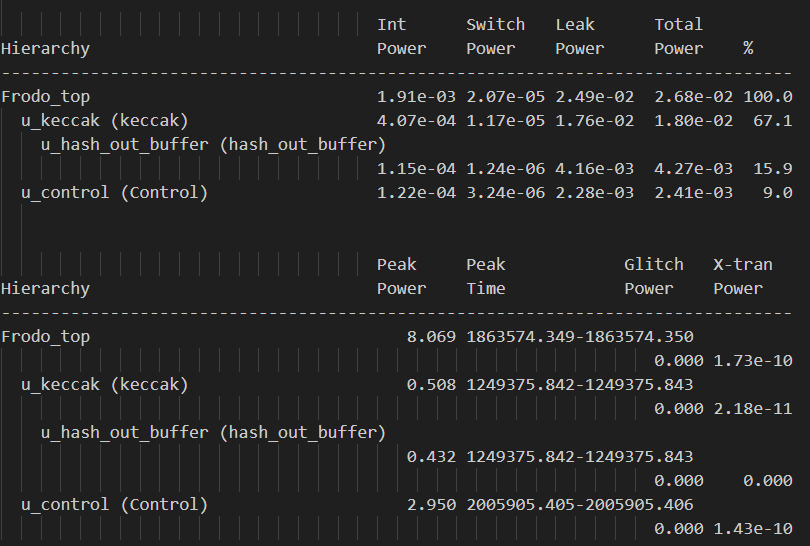
[picture p27: figure]

由图可知24Mhz下PTPX分析出的总峰值功耗为8.069w，其他数据如下表所示：

模块 | Int Power(w) | Swtich Power(w) | Leak Power(w) | Total Power(w)
总体工程 | 1.91e ⁻ ³ | 2.07e ⁻ ⁵ | 2.49e ⁻ ² | 2.68e ⁻ ²
keccak | 4.07e ⁻ ⁴ | 1.17e ⁻ ⁵ | 1.76e ⁻ ² | 1.80e ⁻ ²
Control | 1.22e ⁻ ⁴ | 3.24e ⁻ ⁶ | 2.28e ⁻ ³ | 2.41e ⁻ ³
其他模块 | 1.38e ⁻³ | 5.76e ⁻ ⁶ | 5.02e ⁻ ³ | 6.39e ⁻ ³

# 3. 上板验证结果

以下结果系统时钟为200MHz，Frodo_top的时钟频率为pll的输出频率为100MHz。

## 3.1. Frodo640

### 3.1.1. Keygen生成pkh

硬件仿真结果：

mem1_addr = fd2 , output_data = db2e85b3977dca13

mem1_addr = fd3 , output_data = adfb88507c1be248

上板波形：

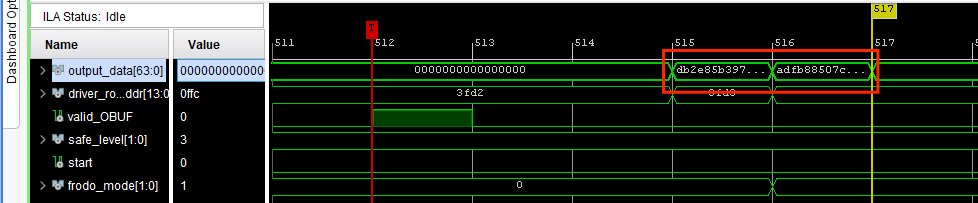
[picture p28: figure]
0903a0d124c60b48f928facae645456

### 3.1.2. Encaps生成ss

硬件仿真结果：

mem0_addr = ffc , output_data = 11fbdbd5e72cd42e

mem0_addr = ffd , output_data = fab350b6dc2b2e5f

上板波形：

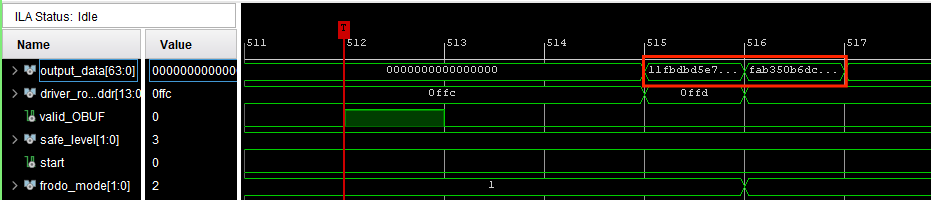
[picture p29: figure]
83fef9b4126a813b1de3d5ad47b276b

### 3.1.3. Decaps生成ss

硬件仿真结果：

mem1_addr = fd6 , output_data = 11fbdbd5e72cd42e

mem1_addr = fd7 , output_data = fab350b6dc2b2e5f

上板波形：

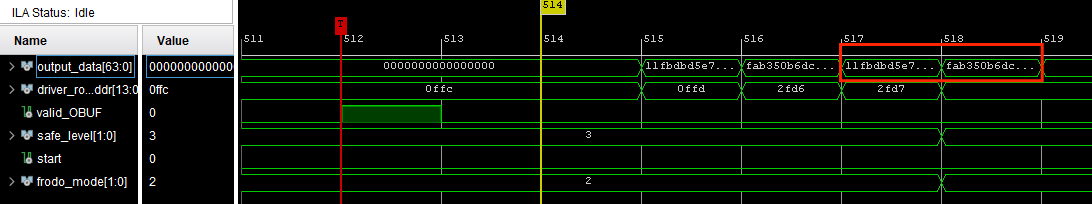
[picture p30: figure]
7b2ac93768ce701d89034bad261ea0e

通过比对，数据一致，说明Frodo640安全等级下，各算法流程执行正确

## 3.2. Frodo976

### 3.2.1. Keygen生成pkh

硬件仿真结果：

mem1_addr = fd2 , output_data = 3e04668a8d7a1f9b

mem1_addr = fd3 , output_data = af5072a3962884da
mem1_addr = fd4 , output_data = cfc763dd12a3802c

上板波形：

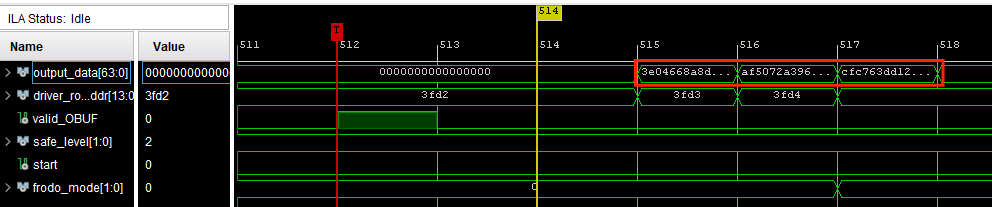
[picture p31: figure]
2143d0cea79af862f1b5b65799f5ca0

### 3.2.2. Encaps生成ss

硬件仿真结果：

mem0_addr = ffc , output_data = e7f8d5a3695a6e5b

mem0_addr = ffd , output_data = d05e59956e3aea5e
mem0_addr = ffd , output_data = 4231378b5ba58d27

上板波形：

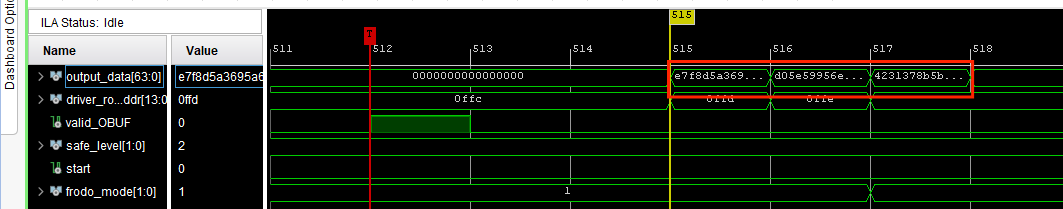
[picture p32: figure]
caf819b7760c5350e79d27f0a1de723

### 3.2.3. Decaps生成ss

硬件仿真结果：

mem1_addr = fd6 , output_data = e7f8d5a3695a6e5b

mem1_addr = fd7 , output_data = d05e59956e3aea5e
mem1_addr = fd8 , output_data = 4231378b5ba58d27

上板波形：

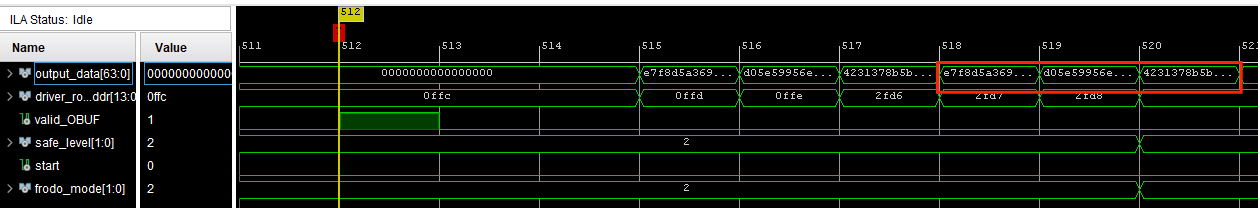
[picture p33: figure]
68fdf9510670ba6dba890378501e5f0

通过比对，数据一致，说明Frodo976安全等级下，各算法流程执行正确

## 3.3. Frodo1344

### 3.3.1. Keygen生成pkh

硬件仿真结果：

mem1_addr = fd2 , output_data = 1620695d8773363a

mem1_addr = fd3 , output_data = 96ba22f90b7b5e27
mem1_addr = fd4 , output_data = df0445d51223a7b1

mem1_addr = fd5 , output_data = 797d67e53576d438

上板波形：

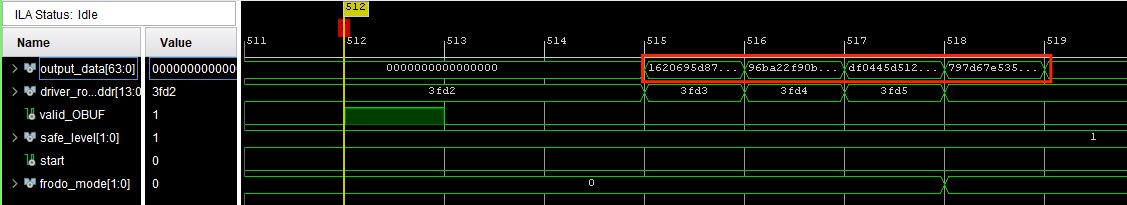
[picture p34: figure]
1dee5036a10ade7230ee26b5a3af6ab

### 3.3.2. Encaps生成ss

硬件仿真结果：

mem0_addr = ffc , output_data = 9ef14d4671f9208d

mem0_addr = ffd , output_data = e2d0af85d3bd6105

mem0_addr = ffd , output_data = 635ad4ef12e20cef

mem0_addr = ffe , output_data = ac6ad6f3642c5d2f

上板波形：

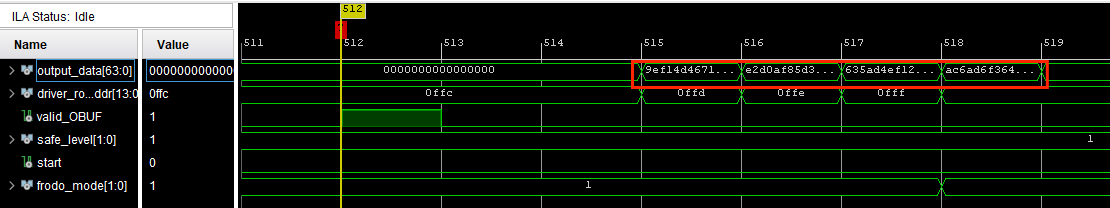
[picture p35: figure]
271bf41d8477e163c7ece4453afa26e

### 3.3.3. Decaps生成ss

硬件仿真结果：

mem1_addr = fd6 , output_data = 9ef14d4671f9208d

mem1_addr = fd7 , output_data = e2d0af85d3bd6105
mem1_addr = fd8 , output_data = 635ad4ef12e20cef

mem1_addr = fd9 , output_data = ac6ad6f3642c5d2f

上板波形：

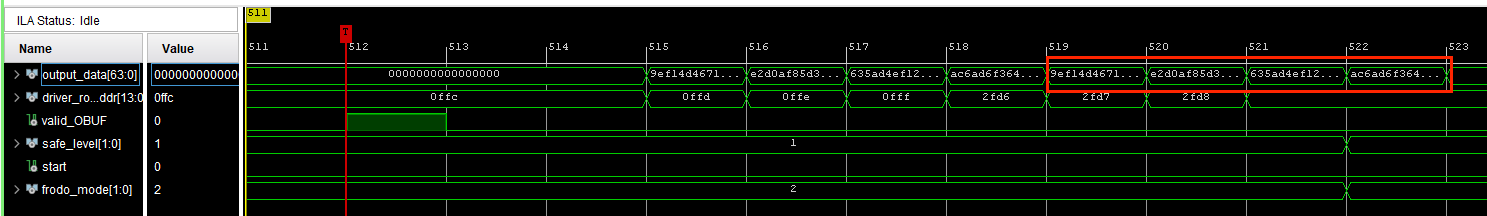
[picture p36: figure]
cdd0421a9036982e415ed17e14b17d3

通过比对，数据一致，说明Frodo1344安全等级下，各算法流程执行正确

# 4. 附录

## 4.1. 算法执行指令

### 4.1.1. Frodo640

Keygen

1100101111100000000000000011 //吸收5f absorb_s

0001111111000000001000100000 //吸收seedse absorb 长度256

0111010100100000000000100100 // genS

0110000000100000000000000101 //genE

0001111111100000000100000010 //吸收z absorb 长度128

0100000000000000000100000001 //absorb_ex,长度128

0101111110100000000100100000 //生成seedA,长度128

1110001001100100000000000000 //Amatmul B = AS + E

0001111110100000000100100010 //absorb 吸收seedA,长度128

0000000000100000000000000001 // pkh,吸收矩阵B

0100000000000000001010000001 //执行一次吸收

0101111110100100000100100000 //挤出pkh,长度128

Encaps

0001111110100000000100100010

0000000000100000000000000001

0100000000000000001010000001

0101111110100100000100100000 //生成pkh

0001111110100100000100100010 //吸收pkh

0001111111100100000100000000 //吸收u

0001111111110000001000100000 //吸收salt

0100000000000000010000000001 //执行吸收，长度512

0101111111000000001000100000 //生成seedse，长度256

0101111111101100000100000000 //生成k，长度128

1101001011000000000000000011 //吸收96

0001111111000000001000100000 //吸收seedse

0111010100100000000000000100 //生成S'

0110000000100000000000101101 //生成E'

0101111110100000000100000100 //生成E''前1行（128bit）

1010000000000000000000000001 //执行一次挤压

0101111110100100011100000100 //生成E''后7行 （896bit）

1010100010001010000000000000 //转置E''

1000110001001010000000000000 // 生成V_T

1010101010101000000000000000 //转置V

1100111011101010000000000000 //encodeu

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

c93ea3331e29f546, a472a4fd4b5ed091, d467bb54d5824970, 8537ab16faad7956,

104efc5667e20662, 6ce24a3d9f1ea841, 264d5c0f72d53785, a2691a875a0ffba9,

//c2(ct)

217a156619e8d44f, 3f3f0e6b2e7bb68e, 474c783e3c918b05, 4364e3146603b66f,

7269aae6f2fb3c6e, 5e0f62dc186658d2, a2a1dc83e65f45b3, 564d85f32b07d3d8,

22e3ff79306cae45, 458b26afa644453b, f91c11ebc4ed26f8, 9e2496262683ca38,

8028836fb6750b15, ae51f5b969b6e284, 75f283821e984349, 18e0e7a5e342520d,

//salt见Encaps input

Decaps input（ct）

ct 见 Encaps outpu

Decaps output（ss）

// ss

8d20f971464df19e

0561bdd385afd0e2

ef0ce212efd45a63

2f5d2c64f3d66aac
