Jokersherlock/Frodo_low_runahead/doc/old design/地址规划.xlsx

ram号 | 端口号
1 | / | seedSE_keygen
1 | 0 | S_keygen
0 | 0 | E_keygen | B_keygen |  |  |  |  |  |  |  |  |  | ram号 | 端口 | index
1 | 1 | seedA_keygen |  |  |  |  | seedSE | 4064 | fe0 | 1111 | 1110 | 0000 | 1 | /
 |  | E'_encap | B'_encap |  |  |  | S_keygen | 2704 | A90 | 1010 | 1001 | 0000 | 1 | 0/1 | 0001/1011
0 | 1 | S'encap |  |  |  | B | E_keygen | 16 | 10 | 0000 | 0001 | 0000 | 0 | 0 | 0010
1 | 0 | E''_encap_T | V_T |  |  |  | z | 4080 | FF0 | 1111 | 1111 | 0000 | 0 | 0
0 | / | E''_encap |  |  |  |  | seedA_keygen | 4048 | FD0 | 1111 | 1101 | 0000 | 1 | 1 | 0011
0 |  | V |  |  |  |  | pkh | 4050 | FD2 | 1111 | 1101 | 0010 | 1 | /
1 |  | Encode(u) |  |  |  |  | salt_encap | 4088 | FF8 | 1111 | 1111 | 1000 | 1
0 |  | u |  |  |  |  | u_encap | 4082 | FF2 | 1111 | 1111 | 0010 | 0 | 0/1 | 0111/1100
 |  |  |  |  |  |  | seedSE' | 4064 | fe0 | 1111 | 1110 | 0000 | 1
 |  |  |  |  |  |  | k | 4086 | ff6 | 1111 | 1111 | 0110 | 0
 |  |  |  |  |  |  | S' | 2704 | A90 | 1010 | 1001 | 0000 | 0 | 1 | 0110
 |  |  |  |  |  | B' | E' | 16 | 10 | 0000 | 0001 | 0000 | 1 | 1 | 1000
 |  |  |  | M | C_decap | V | E'' | 4048 | FD0 | 1111 | 1101 | 0000 | 0 | 0 | 0100
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
