Jokersherlock/Frodo_low_runahead/doc/old design/微指令地址规划.xlsx

func | opcode | 名称
0 | 000 | absorb | 1
0 | 001 | ss0 | 9
0 | 010 | squeeze | 29
0 | 011 | genS | 42
0 | 100 | matmul | 80
0 | 101 | matran | 94
0 | 110 | trans | 117
0 | 111 | Amatmul | 128
1 | 000 | pkh | 202
1 | 001 | ss1 | 256
1 | 010 | absorb_ex | 286
1 | 011 | genE | 295
1 | 100 | matadd | 343
1 | 101 | squeeze_ex | 350
1 | 110 | absorb_s | 358
1 | 111 | matmulA | 362
 |  | pkh_640/ss1_640 | 437
 |  | ss0_640 | 466
