Jokersherlock/Frodo_low_runahead/doc/old design/指令.xls

 | opcode |  |  |  |  |  |  |  |  |  |  |  |  |  |  |  |  |  |  |  |  |  |  |  |  |  |  | func
 | 26 | 25 | 24 | 23 | 22 | 21 | 20 | 19 | 18 | 17 | 16 | 15 | 14 | 13 | 12 | 11 | 10 | 9 | 8 | 7 | 6 | 5 | 4 | 3 | 2 | 1 | 0 | -1
TRANS | 1 | 1 | 0 |  |  |  |  | Src |  |  |  | Dst |  |  |  | mode
MATMUL | 1 | 0 | 0 | Src_s |  |  |  | Src_l |  |  |  | Dst |  |  |  | signal
MATRAN | 1 | 0 | 1 |  |  |  |  | Src |  |  |  | Dst |  |  |  | mode
ABSORB | 0 | 0 | 0 | Addr |  |  |  |  |  |  |  |  |  |  |  | Length |  |  |  |  |  | 15to8 | port | inverse |  |  | ram_reset
pkh | 0 | 0 | 0 | Addr |  |  |  |  |  |  |  |  |  |  |  |  |  |  |  |  |  |  | port |  |  |  |  | 1
squeeze | 0 | 1 | 0 | Addr |  |  |  |  |  |  |  |  |  |  |  | Length |  |  |  |  |  |  | port | inverse |  | sample
ss | 0 | 0 | 1 | Addr |  |  |  |  |  |  |  |  |  |  |  |  |  |  |  |  |  |  |  |  |  |  |  | 0/1
genS | 0 | 1 | 1 | Addr |  |  |  |  |  |  |  |  |  |  |  |  |  |  |  |  |  |  |  |  |  | sample |  | 0
genE | 0 | 1 | 1 | Addr |  |  |  |  |  |  |  |  |  |  |  |  |  |  |  |  |  |  | port |  | mode | sample |  | 1
Amatmul | 1 | 1 | 1 | S |  |  |  | seedA |  |  |  | E
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
