Jokersherlock/Frodo_low_runahead/src/rtl/v2/Hash/hash_out_buffer.v

module hash_out_buffer
(   input wire clk,
    input wire rst,
    
    input wire [4:0] Rnd_cnt,
    input wire [2:0] Sub_Rnd_cnt,
    input wire [2:0] state,
 
    
    input wire [0:199] ci_out,
    input wire         dout_en,
    
    //output reg [1:0] dout_en_cnt,
    //output wire [0:63] Hash_64out
    //output reg [0:15] Hash_16out
    output wire [0:15] Hash_16out
);

reg [0:1343] Hash_out_buffer;//1344

//reg [4:0]    buffer_out_cnt;
//reg          buffer_out_en;//////连续输出使用   
//wire [0:63]  Hash_64out;

//assign Hash_64out = dout_en ? Hash_out_buffer[0:63] : 64'd0; 
//assign Hash_64out = Hash_out_buffer[0:63];
//assign Hash_64out = {Hash_out_buffer[48:63],Hash_out_buffer[32:47],Hash_out_buffer[16:31],Hash_out_buffer[0:15]};
//assign Hash_64out = {Hash_out_buffer[56:63],Hash_out_buffer[48:55],Hash_out_buffer[40:47],Hash_out_buffer[32:39],Hash_out_buffer[24:31],Hash_out_buffer[16:23],Hash_out_buffer[8:15],Hash_out_buffer[0:7]};
assign Hash_16out = {Hash_out_buffer[8:15],Hash_out_buffer[0:7]};
//reg [1:0] dout_en_cnt;

// always @(posedge clk or posedge rst) begin
//     if(rst) begin
//         dout_en_cnt <= 2'd0;
//     end
//     else if(dout_en) begin
//         dout_en_cnt <= dout_en_cnt + 2'd1;
//     end
//     else begin
//         dout_en_cnt <= dout_en_cnt;
//     end
// end

// always @(*) begin
//     case(dout_en_cnt)
//         2'd0: Hash_16out = {Hash_64out[8:15],Hash_64out[0:7]};
//         2'd1: Hash_16out = {Hash_64out[24:31],Hash_64out[16:23]};
//         2'd2: Hash_16out = {Hash_64out[40:47],Hash_64out[32:39]};
//         2'd3: Hash_16out = {Hash_64out[56:63],Hash_64out[48:55]};
//         default: Hash_16out = 16'd0;
//     endcase
// end



always@(posedge clk or posedge rst)
begin
    if(rst)
            Hash_out_buffer <= 1344'd0;
     else if(dout_en)
           // Hash_out_buffer     <=  {Hash_out_buffer[64:1343],64'd0};
            Hash_out_buffer     <=  {Hash_out_buffer[16:1343],16'd0};
    else if(state == 3'd5)//向buffer里装载数�?
        begin
            if(Rnd_cnt == 5'd24)
                begin
                    case(Sub_Rnd_cnt)
                        3'd7:begin
                               Hash_out_buffer[0:7]             <=  ci_out[0:7]    ;
                               Hash_out_buffer[64:71]           <=  ci_out[8:15]   ;
                               Hash_out_buffer[128:135]         <=  ci_out[16:23]  ;
                               Hash_out_buffer[192:199]         <=  ci_out[24:31]  ;
                               Hash_out_buffer[256:263]         <=  ci_out[32:39]  ;
                               Hash_out_buffer[320:327]         <=  ci_out[40:47]  ;
                               Hash_out_buffer[384:391]         <=  ci_out[48:55]  ;
                               Hash_out_buffer[448:455]         <=  ci_out[56:63]  ;
                               Hash_out_buffer[512:519]         <=  ci_out[64:71]  ;
                               Hash_out_buffer[576:583]         <=  ci_out[72:79]  ;
                               Hash_out_buffer[640:647]         <=  ci_out[80:87]  ;
                               Hash_out_buffer[704:711]         <=  ci_out[88:95]  ;
                               Hash_out_buffer[768:775]         <=  ci_out[96:103] ;
                               Hash_out_buffer[832:839]         <=  ci_out[104:111]; 
                               Hash_out_buffer[896:903]         <=  ci_out[112:119];
                               Hash_out_buffer[960:967]         <=  ci_out[120:127]; 
                               Hash_out_buffer[1024:1031]       <=  ci_out[128:135]; 
                               Hash_out_buffer[1088:1095]       <=  ci_out[136:143];
                               Hash_out_buffer[1152:1159]       <=  ci_out[144:151]; 
                               Hash_out_buffer[1216:1223]       <=  ci_out[152:159]; 
                               Hash_out_buffer[1280:1287]       <=  ci_out[160:167];
                            end
                        3'd6:begin
                              Hash_out_buffer[8:15]             <=  ci_out[0:7]    ;
                              Hash_out_buffer[72:79]            <=  ci_out[8:15]   ;
                              Hash_out_buffer[136:143]          <=  ci_out[16:23]  ;
                              Hash_out_buffer[200:207]          <=  ci_out[24:31]  ;
                              Hash_out_buffer[264:271]          <=  ci_out[32:39]  ;
                              Hash_out_buffer[328:335]          <=  ci_out[40:47]  ;
                              Hash_out_buffer[392:399]          <=  ci_out[48:55]  ;
                              Hash_out_buffer[456:463]          <=  ci_out[56:63]  ;
                              Hash_out_buffer[520:527]          <=  ci_out[64:71]  ;
                              Hash_out_buffer[584:591]          <=  ci_out[72:79]  ;
                              Hash_out_buffer[648:655]          <=  ci_out[80:87]  ;
                              Hash_out_buffer[712:719]          <=  ci_out[88:95]  ;
                              Hash_out_buffer[776:783]          <=  ci_out[96:103] ;
                              Hash_out_buffer[840:847]          <=  ci_out[104:111]; 
                              Hash_out_buffer[904:911]          <=  ci_out[112:119];
                              Hash_out_buffer[968:975]          <=  ci_out[120:127]; 
                              Hash_out_buffer[1032:1039]        <=  ci_out[128:135]; 
                              Hash_out_buffer[1096:1103]        <=  ci_out[136:143];
                              Hash_out_buffer[1160:1167]        <=  ci_out[144:151]; 
                              Hash_out_buffer[1224:1231]        <=  ci_out[152:159]; 
                              Hash_out_buffer[1288:1295]        <=  ci_out[160:167];      
                            end
                        3'd5: begin
                            Hash_out_buffer[16:23]             <=  ci_out[0:7]    ;
                            Hash_out_buffer[80:87]            <=  ci_out[8:15]   ;
                            Hash_out_buffer[144:151]          <=  ci_out[16:23]  ;
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
                            Hash_out_buffer[1144:1151]        <=  ci_out[136:143];
                            Hash_out_buffer[1208:1215]        <=  ci_out[144:151]; 
                            Hash_out_buffer[1272:1279]        <=  ci_out[152:159]; 
                            Hash_out_buffer[1336:1343]        <=  ci_out[160:167];
                        end
                    default : Hash_out_buffer <= Hash_out_buffer;
                    endcase
                end    
            else 
                Hash_out_buffer <= Hash_out_buffer;
        end
    else
        Hash_out_buffer <= Hash_out_buffer;
end



endmodule
