Jokersherlock/Frodo_low_runahead/src/rtl/include/global_define.v

`timescale 1ns / 1ns
`ifndef _GLOBAL_DEFINE_V_
`define _GLOBAL_DEFINE_V_

// Frodo参数定义
`define FRODO_1344 2'b11
`define FRODO_976  2'b10
`define FRODO_640  2'b01
`define KEYGEN 2'b01
`define ENCAP 2'b10
`define DECAP 2'b11

`define UINST_ADDR_WIDTH 8
`define UINST_WIDTH 29

`define INST_WIDTH 28

`define ENCDEC        4'b0001
`define MATMUL        4'b0010
`define MOV           4'b0011
`define AMATMUL       4'b0100
`define MATADD        4'b0101
`define ABSORB        4'b1000
`define SQUEEZE       4'b1001
`define HASH_RND      4'b1010
`define ABSORB_STRM   4'b1011
`define SQUEEZE_STRM  4'b1100
`define ABSORB_BYTE   4'b1101

// 仿真/综合模式切换宏定义
// 注释掉下面这行使用仿真模式（dual_ram, rom模块）
// 取消注释使用综合模式（IP核）
// `define USE_IP_CORE

`define USE_DSP

`endif
