Jokersherlock/Frodo_low_runahead/src/rtl/v2/Control/Register.v

module Register(
    input                   clk,
    input                   rstn,
    input       [63:0]      R0_in,R1_in,R2_in,R3_in,
    input       [2:0]       R0_mask,
    input                   R1_mask,
    
    output      [63:0]      R0_out,R1_out,R2_out,R3_out,
    output      [31:0]      R1_32,
    output reg  [15:0]      R0_16,
    output reg  [7:0]       R0_8
);

    reg [63:0] R3;

    // R0, R1, R2改为组合逻辑，直接输出输入值
    assign R0_out = R0_in;
    assign R1_out = R1_in;
    assign R2_out = R2_in;
    assign R3_out = R3_in;
    
    // // R3保持时序逻辑
    // always @(posedge clk or negedge rstn) begin
    //     if (!rstn) begin
    //         R3 <= 64'h0;
    //     end
    //     else begin
    //         R3 <= R3_in;
    //     end
    // end
    //assign R3_out = R3;
    assign R1_32 = R1_mask ? R1_in[63:32] : R1_in[31:0];

    always@(*) begin
        case (R0_mask[2:1])
            2'b00: R0_16 = R0_in[15:0];
            2'b01: R0_16 = R0_in[31:16];
            2'b10: R0_16 = R0_in[47:32];
            2'b11: R0_16 = R0_in[63:48];
        endcase
    end

    always@(*) begin
        R0_8 = R0_mask[0] ? R0_16[15:8] : R0_16[7:0];
    end

endmodule
