Jokersherlock/Frodo_low_runahead/(commit log)

2025-09-08 基本完成对新微程序的脑测
2025-09-08 修改了agu,增加addr2,3的carry模式
2025-09-10 Control模块简单连线完成,下一步先测试循环微指令
2025-09-10 修改了uinst的顺序
2025-09-10 minist.py完成
2025-09-16 增添了ip宏定义功能
2025-09-17 所有指令的硬件基础简易完成版
2025-09-21 修改了指令的命名
2025-09-21 完成了汇编器
2025-09-21 汇编器通过验证
2025-09-21 纠正了写ram时写使能的错误，生成seedA验证通过
2025-09-22 删除了adder_carry，重构了一下python辅助,还没有验证
2025-09-22 new py,删除了adder_carry
2025-09-22 uinst.bin删除了addr_carry3位
2025-09-22 修复了不知道为什么SQUEEZE_STRM少了一行
2025-09-22 修正了汇编器的路径错误
2025-09-23 对比找错
2025-09-23 Amatmul验证了一半，1行对了，第2行错了，毁灭吧
2025-09-23 测了一下640的时间
2025-09-28 删除inverse，v2也许可能也要变成屎山了
2025-09-28 准备放假！
